alecot907/smartplug/PCB/kicad/smartplug.kicad_pcb

## KiCad design PCB/kicad/smartplug.kicad_pcb (2024-03-02)

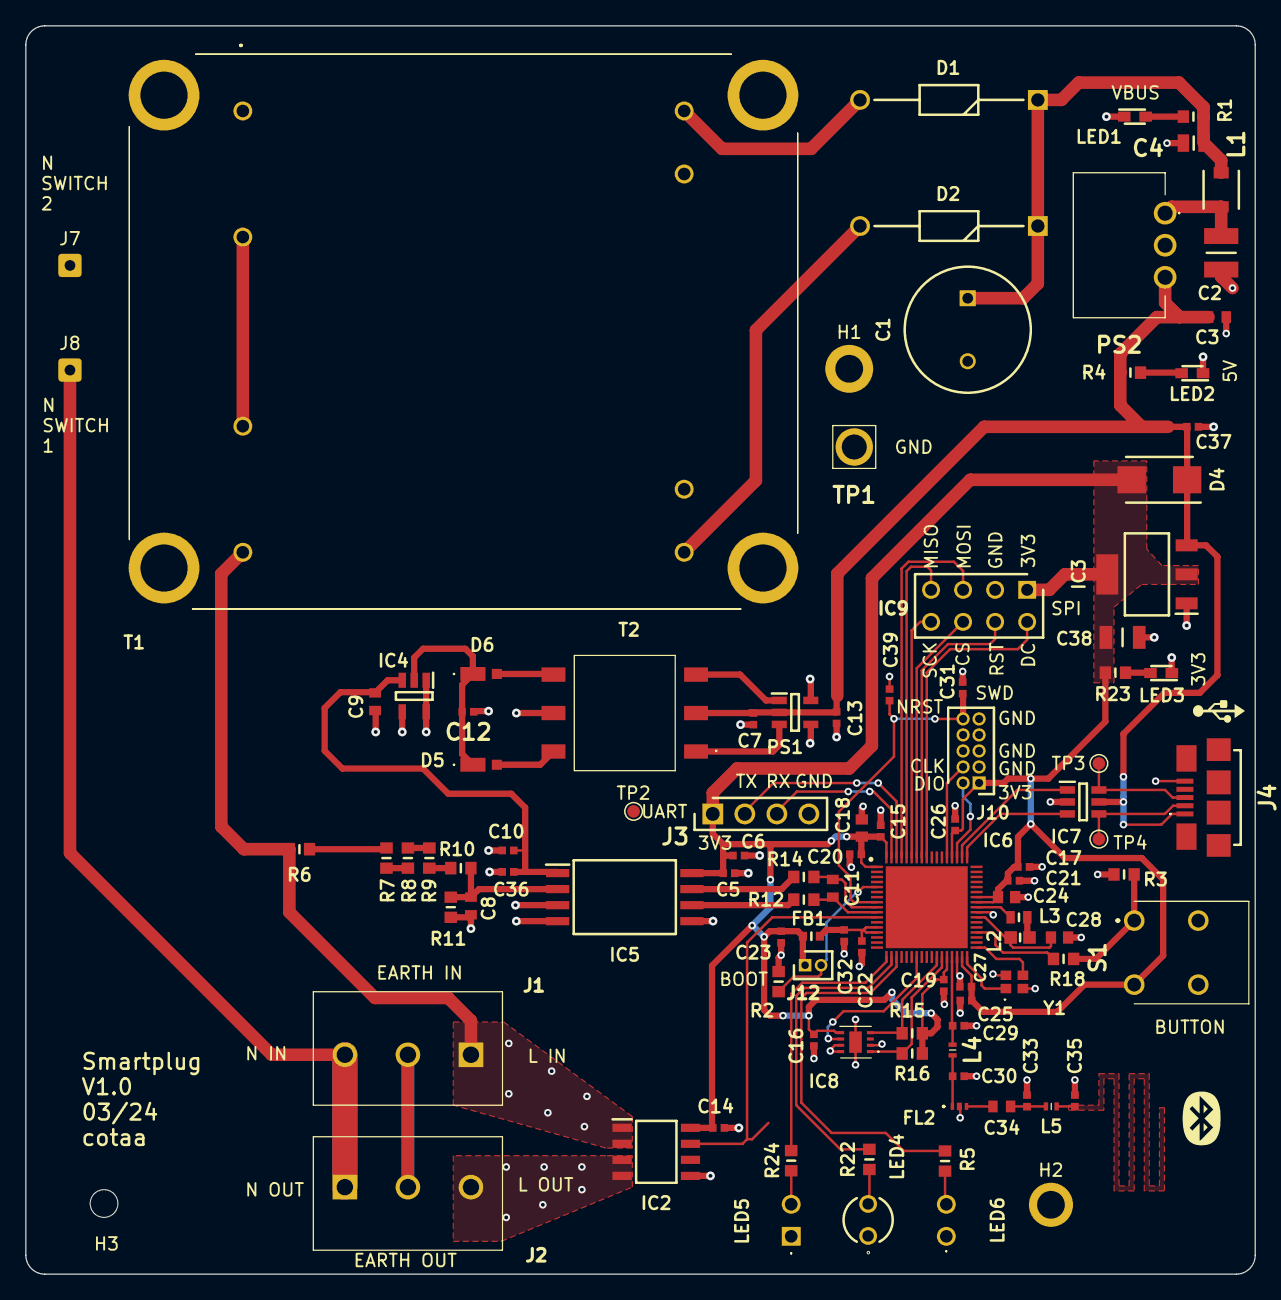
[picture p1: board smartplug.kicad_pcb from above]

Board: 2 copper layers, 97.5 x 99.0 mm, 105 parts (0 on the bottom side), 70 nets.

Parts:
C1: 470u; CAPPRD500W65D1000H2200
C2: 10u; CAPC3225X270N
C3: 22u; CAPC1608X90N
C4: 4.7u; CAPC2012X135N
C5, C7, C12, C13, C23, C32, C36, C37: 1u; CAPC1005X55N
C6, C10, C14, C15, C16, C17, C19, C20, C21, C22, C25, C26, C31, C39: 0.1u; CAPC1005X55N
C8, C11: 1n; CAPC1608X90N
C9: 10u; CAPC1608X90N
C18, C24, C28: 4.7u; CAPC1608X95N
C27: 100p; CAPC1005X55N
C29: 0.8p; CAPC1005X55N
C30: 0.3p; CAPC1005X55N
C33: n.f.; CAPC1005X55N
C34: 10n; CAPC1608X90N
C35: 1.2p; CAPC1005X55N
C38: 2.2u; CAPC3116X180N
D1, D2: 1N4007RLG; DIOAD1405W86L465D235
D4: S1AB-13-F; DIOM5336X250N
D5, D6: PD3S120L-7; PD3S120L7
FB1: 120R; BLM18EG101TH1D
FL2: LFB182G45CGFD436
H1: MountingHole_Pad; MountingHole_2.2mm_M2_ISO14580_Pad
H2: MountingHole_Pad; MountingHole_2.2mm_M2_ISO7380_Pad
H3: MountingHole; MountingHole_2.2mm_M2_ISO7380
IC2: SOIC127P600X175-8N
IC3: SOT230P700X180-4N
IC4: SOT95P280X145-5N
IC5: SOIC127P1150X280-8N
IC6: QFN40P800X800X100-69N-D
IC7: SOT95P280X145-6N
IC8: SHT30DISB25KS
IC9: 534998-4; RHDR8W76P254X254_2X4_1016X503X673P
J1, J2: 1935174
J3: 826629-4; HDRV4W64P0X254_1X4_1016X254X834P
J4: 10118192-0002LF; 101181920002LF
J7, J8: Conn_01x01; SolderWire-0.25sqmm_1x01_D0.65mm_OD1.7mm
J10: HDRV10W45P127_2X5_635X343X575P
J12: M50-3530242; HDRV2W40P0X127_1X2_254X210X420P
L1: 12u; 1227ASH100MP2
L2: 10uH; INDC1608X95N
L3: 10 nH; LQW18AS10NG0CD
L4: 2.7n; LQG15WH0N7B02D
L5: 3.6n; LQG15WH0N7B02D
LED1, LED2, LED3: GREEN; LEDM168X50N
LED4: GREEN; 151034GS03000
LED5: RED; 151033RS03000
LED6: BLUE; 151034BS03000
PS1: SOT95P280X145-5N
PS2: VXO7805-1000; VXO780121000
R1: 2.2k; RESC1608X55N
R2, R3, R15, R16, R18: 10K; RESC1608X55N
R4: 300R; RESC1608X55N
R5: 47R; RESC1608X55N
R6, R7, R8, R9, R10: 715k; RESC1608X55N
R11: 52.3k; RESC1608X55N
R12, R14: 10R; RESC1608X55N
R22, R23, R24: 120R; RESC1608X55N
S1: 800SP9B5M6RE
T1: FL69
T2: 750313769
TP1: 5023
TP2, TP3, TP4: TestPoint; TestPoint_Pad_D1.0mm
Y1: 32MHZ; NX2016SA32MEXS00ACS06465

Connections:
5V_ISO: C9.2, C10.1, C36.2, IC4.3 (OUT), IC5.1 (VDD1)
+3.3V: C5.2, C6.1, C14.1, C15.1, C16.1, C17.1, C18.2, C19.1, C20.1, C21.1, C23.2, C24.2, C25.1, C26.1, C27.2, C38.2, D4.2, FB1.1, IC2.8 (VS), IC3.2 (OUT_1), IC3.4 (OUT_2), IC5.8 (VDD2), IC6.1 (VBAT), IC6.30 (VDD_1), IC6.33 (VDDRF), IC6.44 (VDDSMPS), IC6.45 (VDD_2), IC6.55 (VDDUSB), IC6.68 (VDD_3), IC8.5 (VDD), IC9.1, J3.1, J10.1, J12.1, R15.2, R16.2, R23.2, S1.3
+3.3VA: C22.1, C32.2, FB1.2, IC6.13 (VREF+), IC6.14 (VDDA)
+5V: C3.2, C7.2, C13.2, C37.2, D4.1, IC3.3 (IN), IC7.5 (VBUS), J4.1 (VCC), PS1.2 (VCC), PS2.3 (+VOUT), R4.2, T2.2 (PRI_2)
/interfaces/FEED: C35.2, L5.2
/interfaces/MATCH_IMP: C33.1, C34.2, L5.1
AN_IIN: IC2.7 (VOUT), IC6.11 (PC2), TP2.1
AN_VIN+: C11.2, IC6.9 (PC0), R14.2
AN_VIN-: C11.1, IC6.10 (PC1), R12.2
BOOT: IC6.5 (PH3-BOOT0), J12.2, R2.2
DISPLAY_DC: IC6.60 (PC12), IC9.2
DISPLAY_RST: IC6.61 (PD0), IC9.4
DISPLAY_SPI_CS: IC6.62 (PD1), IC9.6
DISPLAY_SPI_MISO: IC6.64 (PB4), IC9.7
DISPLAY_SPI_MOSI: IC6.65 (PB5), IC9.5
DISPLAY_SPI_SCK: IC6.63 (PB3), IC9.8
EARTH: J1.2, J2.2
GND: C1.2, C2.1, C3.1, C4.1, C5.1, C6.2, C7.1, C13.1, C14.2, C15.2, C16.2, C17.2, C18.1, C19.2, C20.2, C21.2, C22.2, C23.1, C24.1, C25.2, C26.2, C27.1, C28.1, C29.1, C30.1, C31.2, C32.1, C33.2, C35.1, C37.1, C38.1, C39.2, FL2.2 (GND), H1.1, H2.1, IC2.5 (GND), IC3.1 (GND), IC5.5 (GND2), IC6.32 (VSSRF), IC6.42 (VSSSMPS), IC7.2 (GND), IC8.2 (ADDR), IC8.7 (R), IC8.8 (VSS), IC8.9 (EP), IC9.3, J3.4, J4.5 (GND), J10.3, J10.5, J10.9, LED1.1, LED2.1, LED3.1, LED4.1, LED5.1, LED6.1, PS1.4 (GND_1), PS1.5 (GND_2), PS2.2 (GND), R2.1, R3.1, S1.2, S1.4, T1.6 (SEC2_2), T1.7 (SEC1_1), T1.MH3, T1.MH4, TP1.1, Y1.2 (GND_1), Y1.4 (GND_2)
L: IC2.1 (IN+_1), IC2.2 (IN+_2), J1.1, R6.1, T1.4 (PRI2_2)
L1: IC2.3 (IN-_1), IC2.4 (IN-_2), J2.3
LED_BLUE: IC6.20 (PA5), R5.1
LED_GREEN: IC6.19 (PA4), R22.1
LED_RED: IC6.18 (PA3), R24.1
N: J1.3, J2.1, J8.1
N1: C8.1, C9.1, C10.2, C12.1, C36.1, IC4.1 (GND), IC4.4 (NC_1), IC4.5 (NC_2), IC5.3 (INN), IC5.4 (GND1), J7.1, R11.1, T1.1 (PRI1_1), T2.5 (SEC_2)
NRST: C31.1, C39.1, IC6.8 (NRST), J10.10
unnamed: C30.2, FL2.1 (IN), L4.1
unnamed: C34.1, FL2.3 (OUT)
unnamed: C12.2, D5.1, D6.1, IC4.2 (IN)
unnamed: C8.2, IC5.2 (INP), R10.2, R11.2
unnamed: IC5.6 (OUTN), R12.1
unnamed: IC5.7 (OUTP), R14.1
unnamed: C28.2, IC6.41 (VFBSMPS), L2.2
unnamed: IC6.43 (VLXSMPS), L3.2
unnamed: L2.1, L3.1
unnamed: LED1.2, R1.1
unnamed: LED2.2, R4.1
unnamed: LED3.2, R23.1
unnamed: LED4.2, R22.2
unnamed: LED5.2, R24.2
unnamed: LED6.2, R5.2
unnamed: PS1.1 (D1), T2.3 (PRI_3)
unnamed: PS1.3 (D2), T2.1 (PRI_1)
unnamed: C2.2, L1.2, PS2.1 (+VIN)
unnamed: R6.2, R7.1
unnamed: R7.2, R8.1
unnamed: R8.2, R9.1
unnamed: R9.2, R10.1
unnamed: T1.2 (PRI1_2), T1.3 (PRI2_1)
unnamed: D2.2, T1.5 (SEC2_1)
unnamed: D6.2, T2.4 (SEC_1)
unnamed: D5.2, T2.6 (SEC_3)
OSC_IN: IC6.35 (OSC_IN), Y1.3 (CRY_2)
OSC_OUT: IC6.34 (OSC_OUT), Y1.1 (CRY_1)
RF1: C29.2, IC6.31 (RF1), L4.2
SWCLK: IC6.56 (PA14), J10.4
SWDIO: IC6.54 (PA13), J10.2
SWITCH: IC6.38 (PB0), R18.1
SW_SWITCH: R3.2, R18.2, S1.1
TH_SENS_RST: IC6.24 (PA9), IC8.6 (NRESET)
TH_SENS_SCL: IC6.28 (PB10), IC8.4 (SCL), R15.1
TH_SENS_SDA: IC6.29 (PB11), IC8.1 (SDA), R16.1
UART1_RX: IC6.67 (PB7), J3.3
UART1_TX: IC6.66 (PB6), J3.2
USB_CONN_D+: IC7.6 (I/O1_2), J4.3 (D+), TP3.1
USB_CONN_D-: IC7.4 (I/O2_2), J4.2 (D-), TP4.1
USB_D+: IC6.53 (PA12), IC7.1 (I/O1_1)
USB_D-: IC6.52 (PA11), IC7.3 (I/O2_1)
VBUS: C1.1, C4.2, D1.1, D2.1, L1.1, R1.2
VIN_AC: D1.2, T1.8 (SEC1_2)
