alecot907/smartplug/FW/smartplug.ioc

Mcu.UserName=STM32WB55RGVx
PA11.Signal=USB_DM
PA12.Signal=USB_DP
PA13.Signal=SYS_JTMS-SWDIO
PA14.Signal=SYS_JTCK-SWCLK
PA3.Signal=GPIO_Output
PA4.Signal=GPIO_Output
PA5.Signal=GPIO_Output
PA9.Signal=GPIO_Output
PB0.Signal=GPIO_Input
PB10.Signal=I2C3_SCL
PB11.Signal=I2C3_SDA
PB3.Signal=SPI1_SCK
PB5.Signal=SPI1_MOSI
PB6.Signal=USART1_TX
PB7.Signal=USART1_RX
PC0.Signal=ADCx_IN1
PC1.Signal=ADCx_IN2
PC12.Signal=GPIO_Output
PC2.Signal=ADCx_IN3
PD0.Signal=GPIO_Output
PD1.Signal=GPIO_Output
PH3-BOOT0.Signal=GPIO_Input
