alecot907/smartplug/(commit log)

2024-02-02 Added PCB and FW projects
    [interfaces.kicad_sch, power.kicad_sch, sensors.kicad_sch, smartplug BOM not for manufacturer.csv, smartplug-PCB-BOM.xlsx, smartplug.kicad_pcb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]
2024-02-02 Moved H3 silk on PCB. Updated manufacturing files.
    [smartplug.kicad_pcb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]
2024-02-28 PCB 1.0: - Corrected 5V generation - Corrected USB ESD protection - Replaced USB type-C with micro type-B
    [interfaces.kicad_sch, power.kicad_sch, smartplug.kicad_pcb]
2024-02-29 Antenna chip replaced with antenna trace on PCB Switch replaced with button Added GND test point Added PD res on Boot pin Added NRST capacitor
    [interfaces.kicad_sch, smartplug.kicad_pcb, uC.kicad_sch]
2024-02-29 Modified year silk
    [smartplug.kicad_pcb]
2024-03-02 Added some test points
    [interfaces.kicad_sch, power.kicad_sch, sensors.kicad_sch, smartplug.kicad_pcb]
